ohararp/ReflowOven/Operation/Images/10_ReflowCyclePeak.JPG

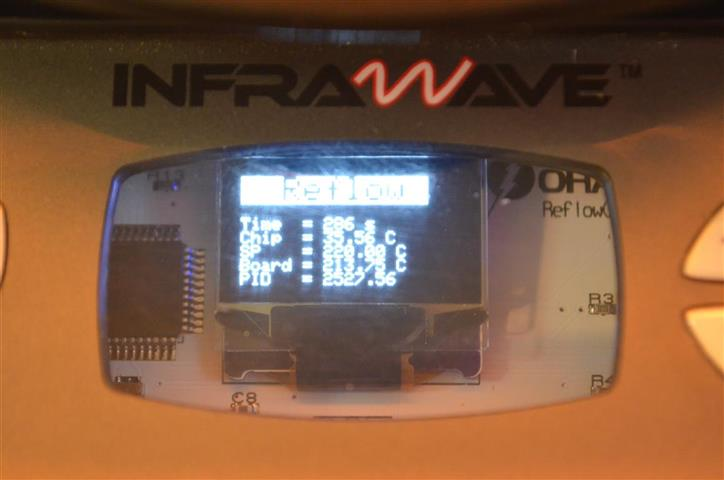
Operation/Images/10_ReflowCyclePeak.JPG
