ohararp/ReflowOven/Operation/Images/5_SettingsStored.JPG

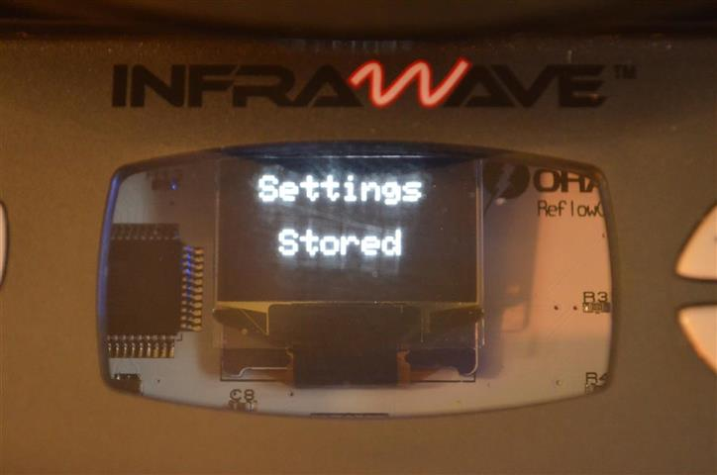
Operation/Images/5_SettingsStored.JPG
