ohararp/ReflowOven/PcbDesignFiles/README.md

These are the design files for the current version of the Reflow Oven Controller and Power Boards.

![Pcb Design Title] (https://github.com/ohararp/ReflowOven/blob/master/PcbDesignFiles/PanelLayout.jpg?raw=true "Panel layout")
