ohararp/ReflowOven/PcbDesignFiles/PanelLayout.jpg

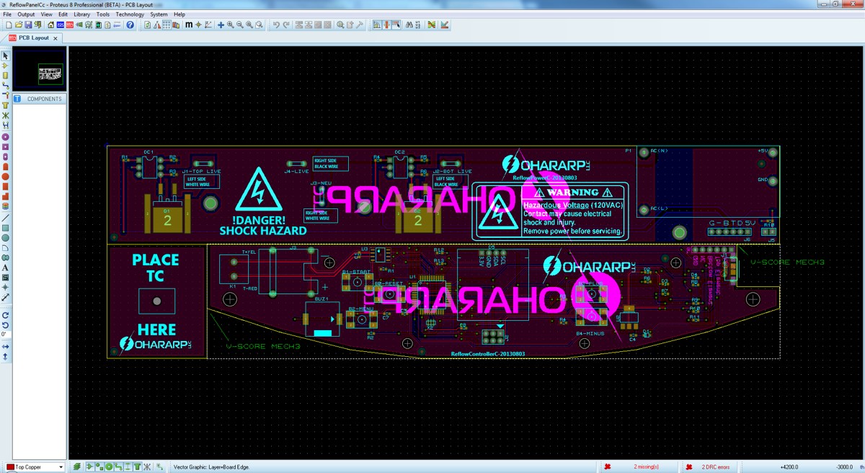
PcbDesignFiles/PanelLayout.jpg
