ohararp/ReflowOven/PcbDesignFiles/PanelReal.jpg

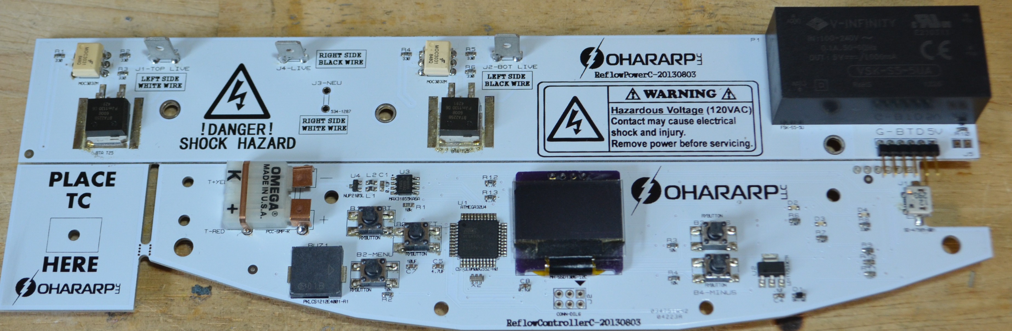
PcbDesignFiles/PanelReal.jpg
