ohararp/ReflowOven/PcbDesignFiles/ReflowControllerC.jpg

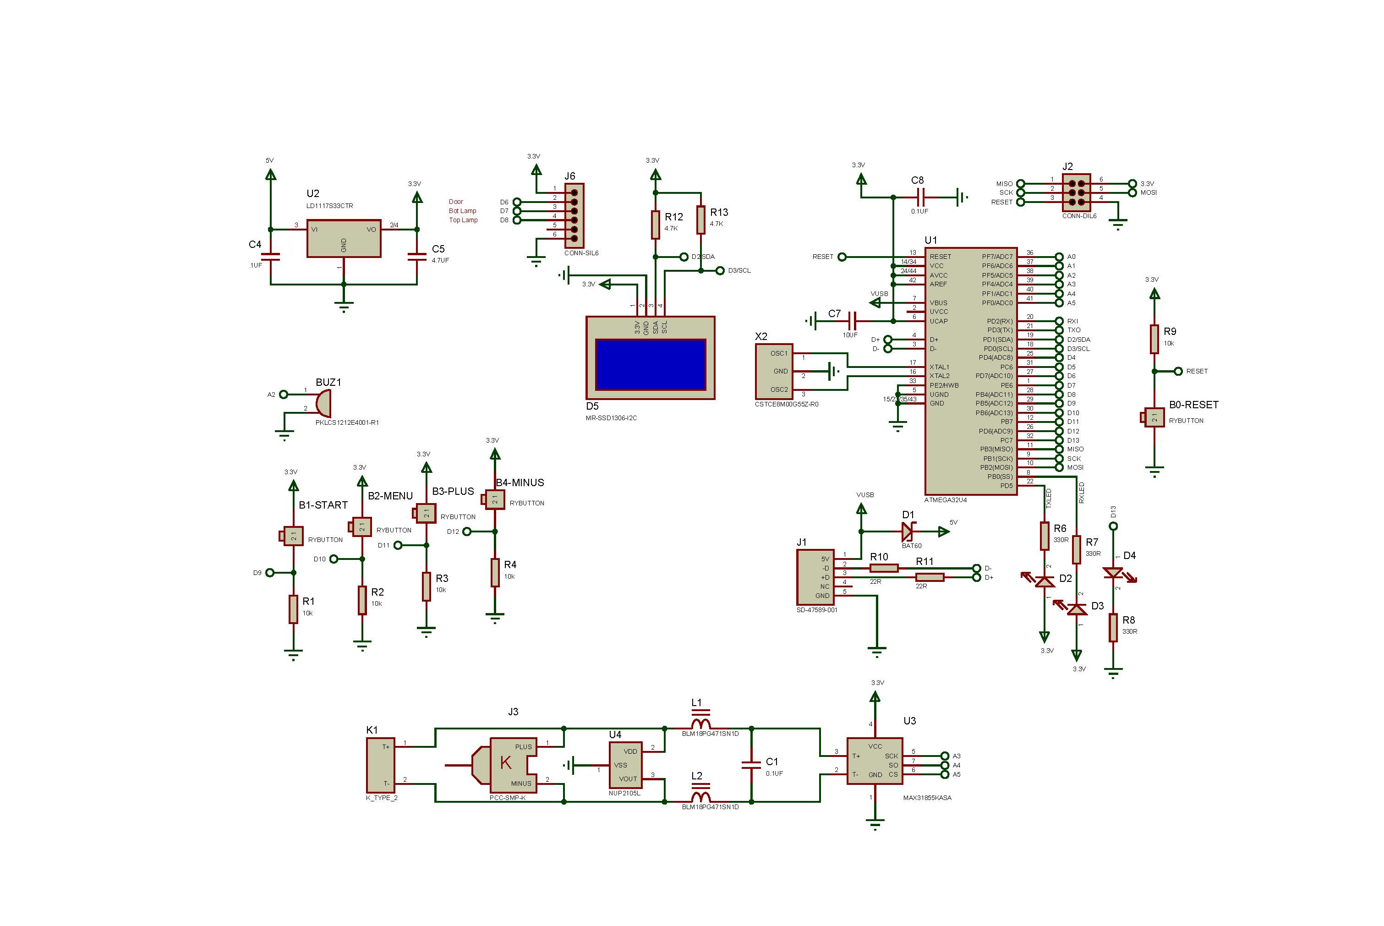
PcbDesignFiles/ReflowControllerC.jpg
