ohararp/ReflowOven/PcbDesignFiles/ReflowPowerC.jpg

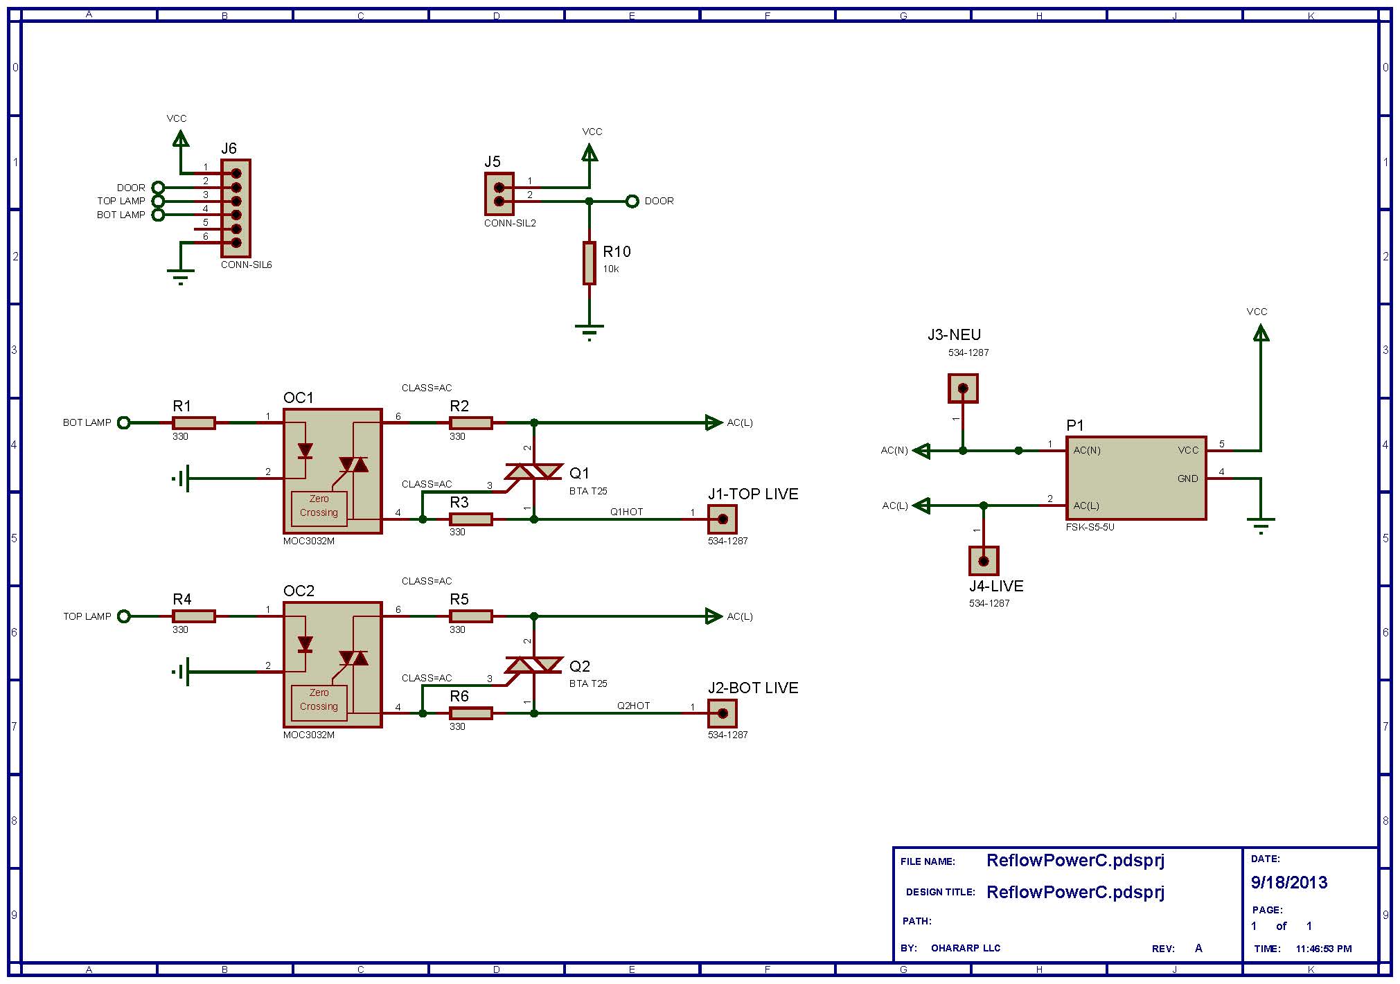
PcbDesignFiles/ReflowPowerC.jpg
