ohararp/ReflowOven/PcbDesignFiles/ReflowPowerC_Bom.pdf

## Bill Of Materials For

### Design Title

### Author

### Document Number

### Revision

Design Created | Tuesday, April 16, 2013
Design Last Modified Wednesday, September 18, 2013

### Total Parts In Design 18

0 Modules

Quantity | References | Value | Stock Code | Unit Cost
Sub-totals: | | | | $0.00

0 Capacitors

Quantity | References | Value | Stock Code | Unit Cost
Sub-totals: | | | | $0.00

7 Resistors

Quantity | References | Value | Stock Code | Unit Cost
2 | R1,R4 | 330 | Mouser 301-470-RC
4 | R2-R3,R5-R6 | 330 | Mouser 302-332-RC
1 | R10 | 10k | Mouser 301-10k-RC
Sub-totals: | | | | $0.00

0 Integrated Circuits

Quantity | References | Value | Stock Code | Unit Cost
Sub-totals: | | | | $0.00

2 Transistors

Quantity | References | Value | Stock Code | Unit Cost
2 | Q1-Q2 | BTA T25 | Digikey 497-10581-1-ND
Sub-totals: | | | | $0.00

0 Diodes

Quantity | References | Value | Stock Code | Unit Cost
Sub-totals: | | | | $0.00

9 Miscellaneous

Quantity | References | Value | Stock Code | Unit Cost
1 | J5 | CONN-SIL2
1 | J6 | CONN-SIL6 | | $0.07
4 | J1-TOP LIVE,J2-BOT LIVE,J3-NEU,J4-LIVE 534-1287 | Mouser 534-1287 | $0.11
2 | OC1-OC2 | MOC3032M Mouser 512-MOC3031SM $1.01
1 | P1 | FSK-S5-5U Digikey 102-1572-ND | $15.00
Sub-totals: | | | | $17.53
Totals: | $17.53

Saturday, December 28, 2013 1:21:27 PM
