ohararp/ReflowOven/Operation/Images/1_TempMenu.JPG

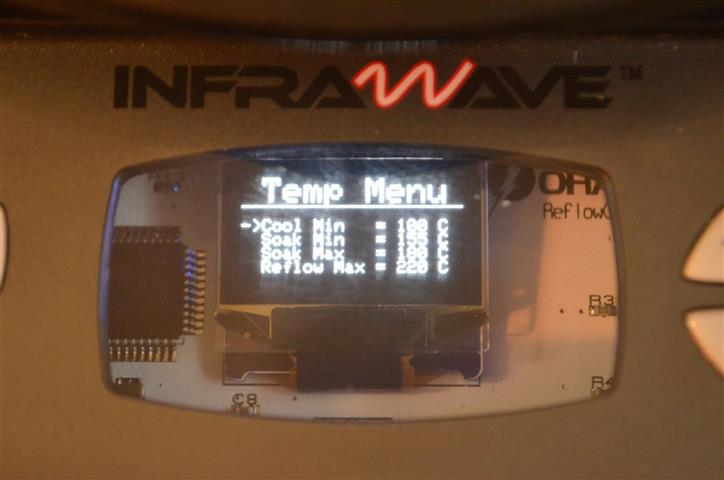
Operation/Images/1_TempMenu.JPG
