ohararp/ReflowOven/Operation/Images/3_SoakMenu.JPG

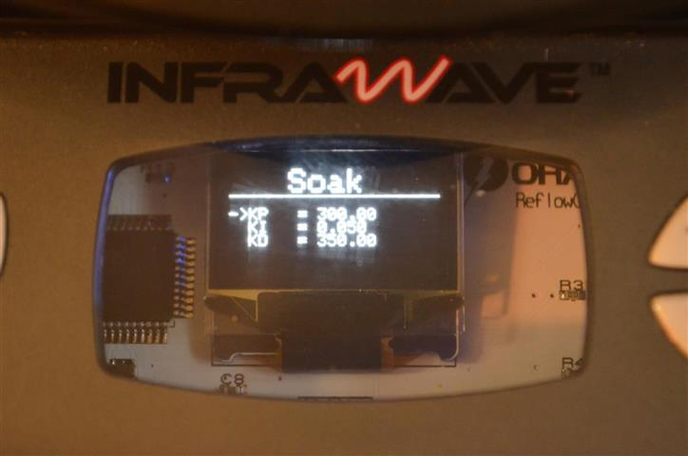
Operation/Images/3_SoakMenu.JPG
