ohararp/ReflowOven/Operation/Images/8_SoakCycle.JPG

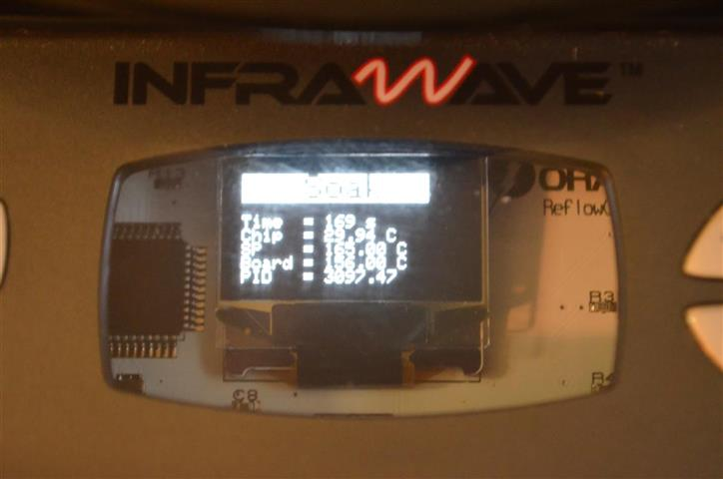
Operation/Images/8_SoakCycle.JPG
