ohararp/ReflowOven/Operation/Images/11_CoolCycle.JPG

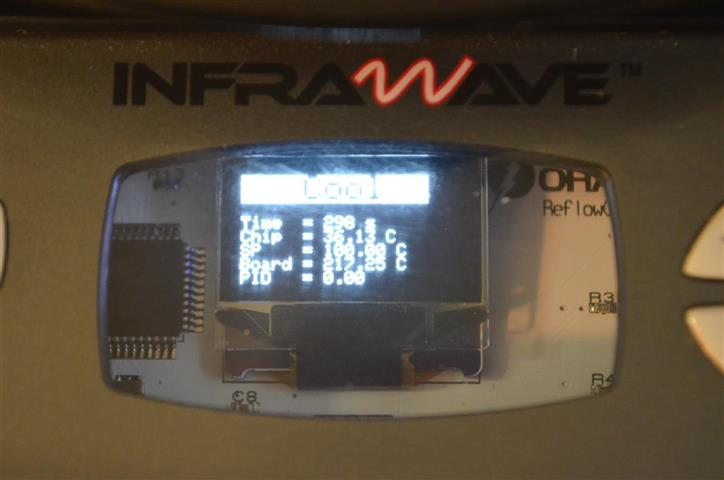
Operation/Images/11_CoolCycle.JPG
