ohararp/ReflowOven/PcbDesignFiles/ReflowControllerC.PDF

U2

J2

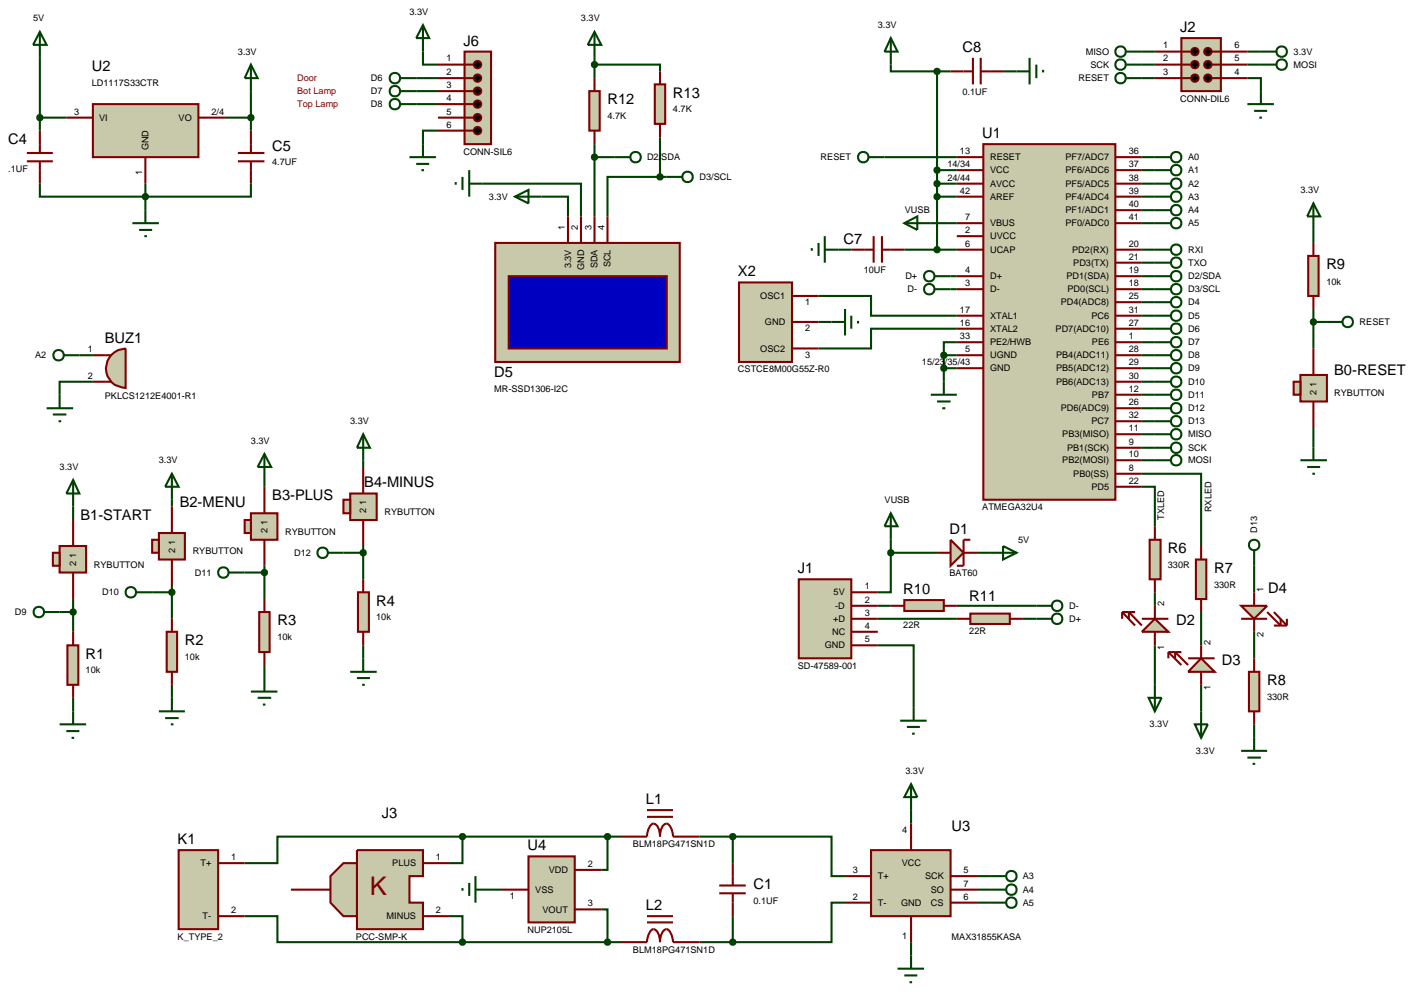
[picture p11: page 1]
