ohararp/ReflowOven/PcbDesignFiles/ReflowPowerC.PDF

J6
J5

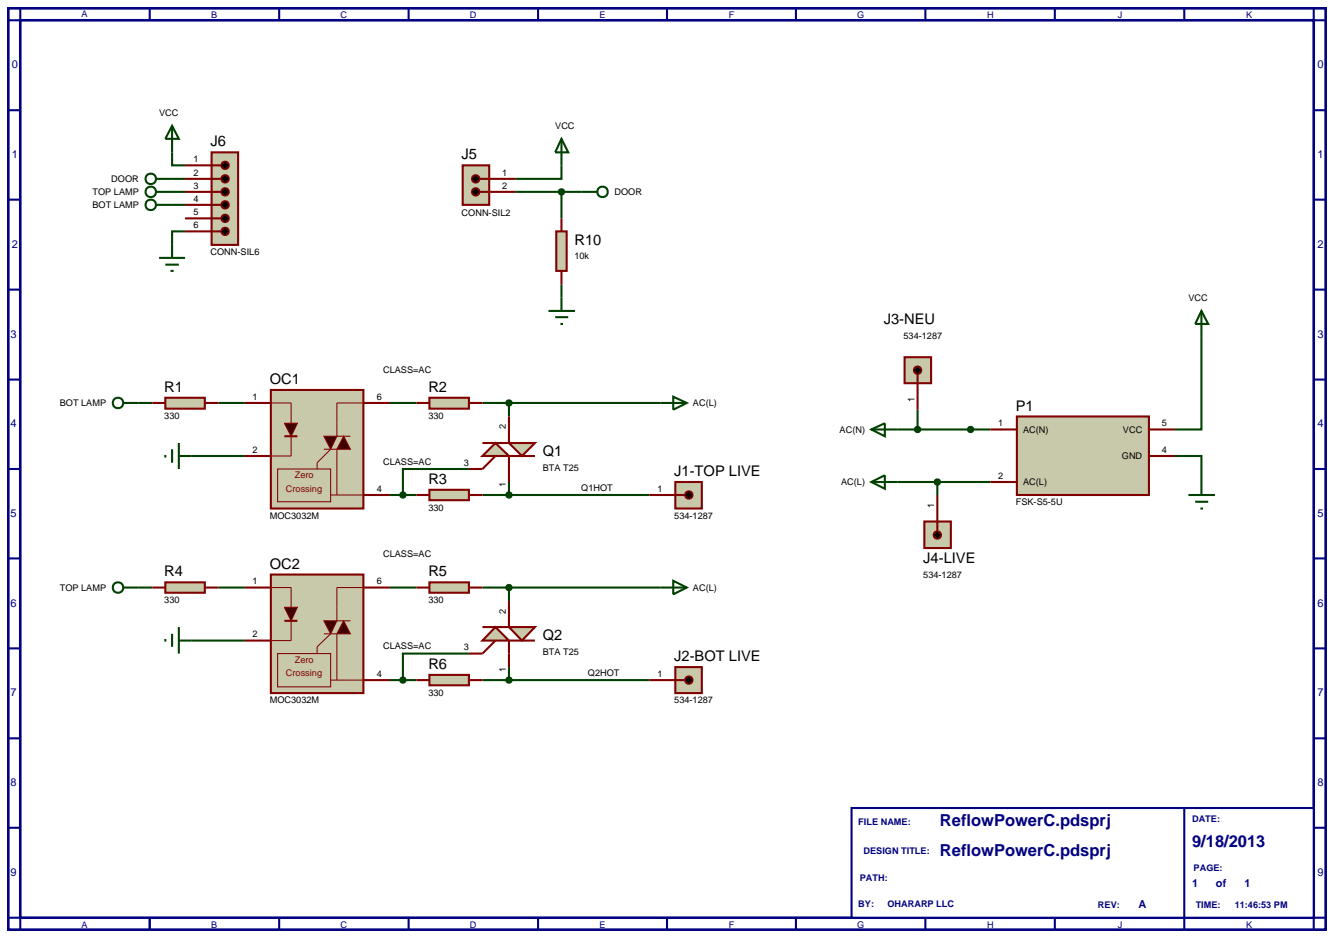
[picture p12: page 1]

FILE NAME:
DESIGN TITLE: ReflowPowerC.pdsprj
