ohararp/ReflowOven/(list of files, drawings)

Other design files:
PcbDesignFiles/ReflowPanelC.pdsprj
