ohararp/ReflowOven/(commit log)

2013-12-28 Add Pcb design schematic, layout, gerbers, bom
    [ReflowPanelC.pdsprj]
2013-12-28 Move Libraries Under Arduino Folder
2013-12-30 Schematic Bitmaps
2013-12-30 Switch to Jpg
